dario0603/Unipi-Frequency-generator/PSD_project/img/BCD_to_C2_converter_BCD_C2_conv_inst.jpg

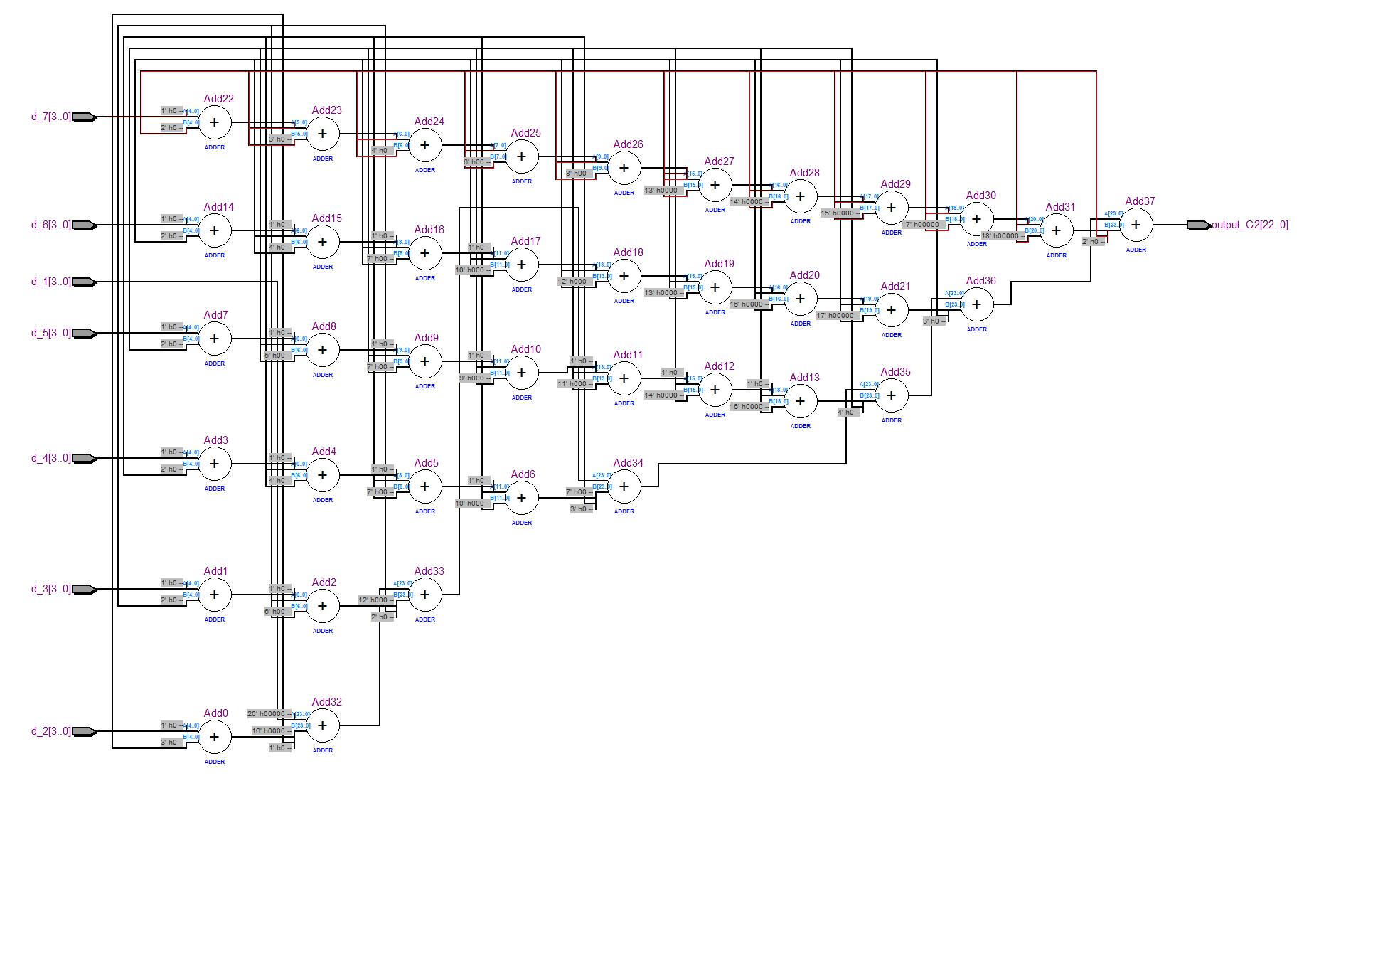
PSD_project/img/BCD_to_C2_converter_BCD_C2_conv_inst.jpg
