dario0603/Unipi-Frequency-generator/PSD_project/img/DDFS_frequency_converter_DDFS_freq_conv_inst.jpg

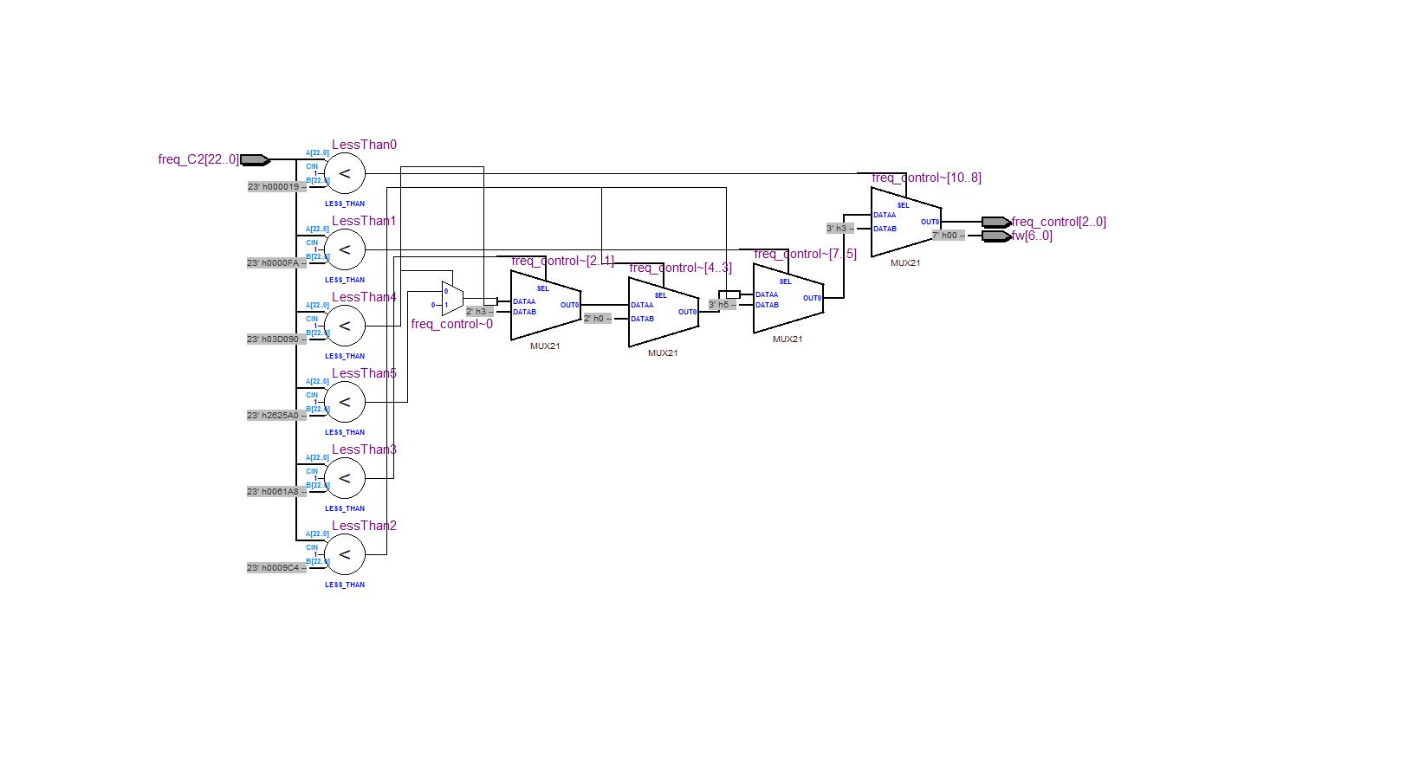
PSD_project/img/DDFS_frequency_converter_DDFS_freq_conv_inst.jpg
