dario0603/Unipi-Frequency-generator/PSD_project/img/ddfs_inst2.jpg

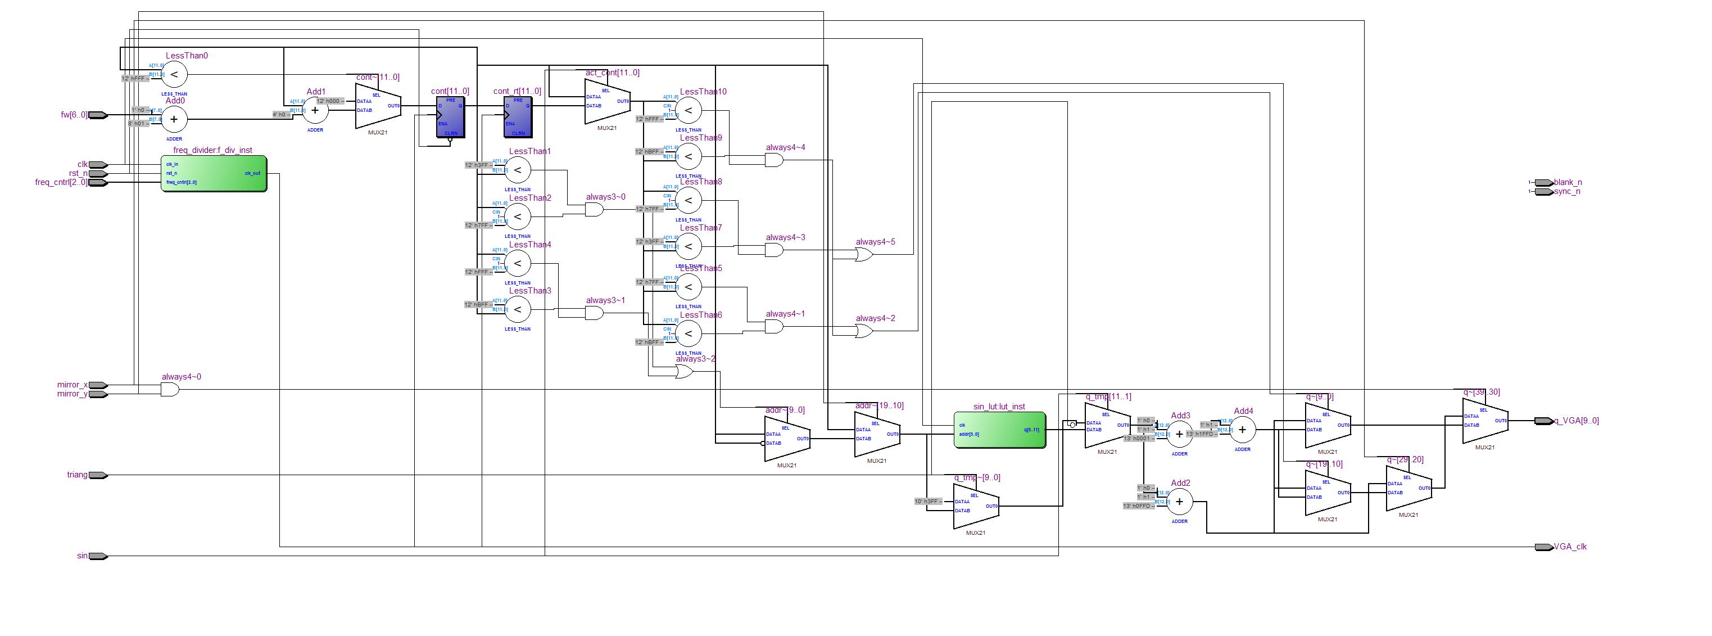
PSD_project/img/ddfs_inst2.jpg
