dario0603/Unipi-Frequency-generator/PSD_project/img/freq_divider_f_div_inst.jpg

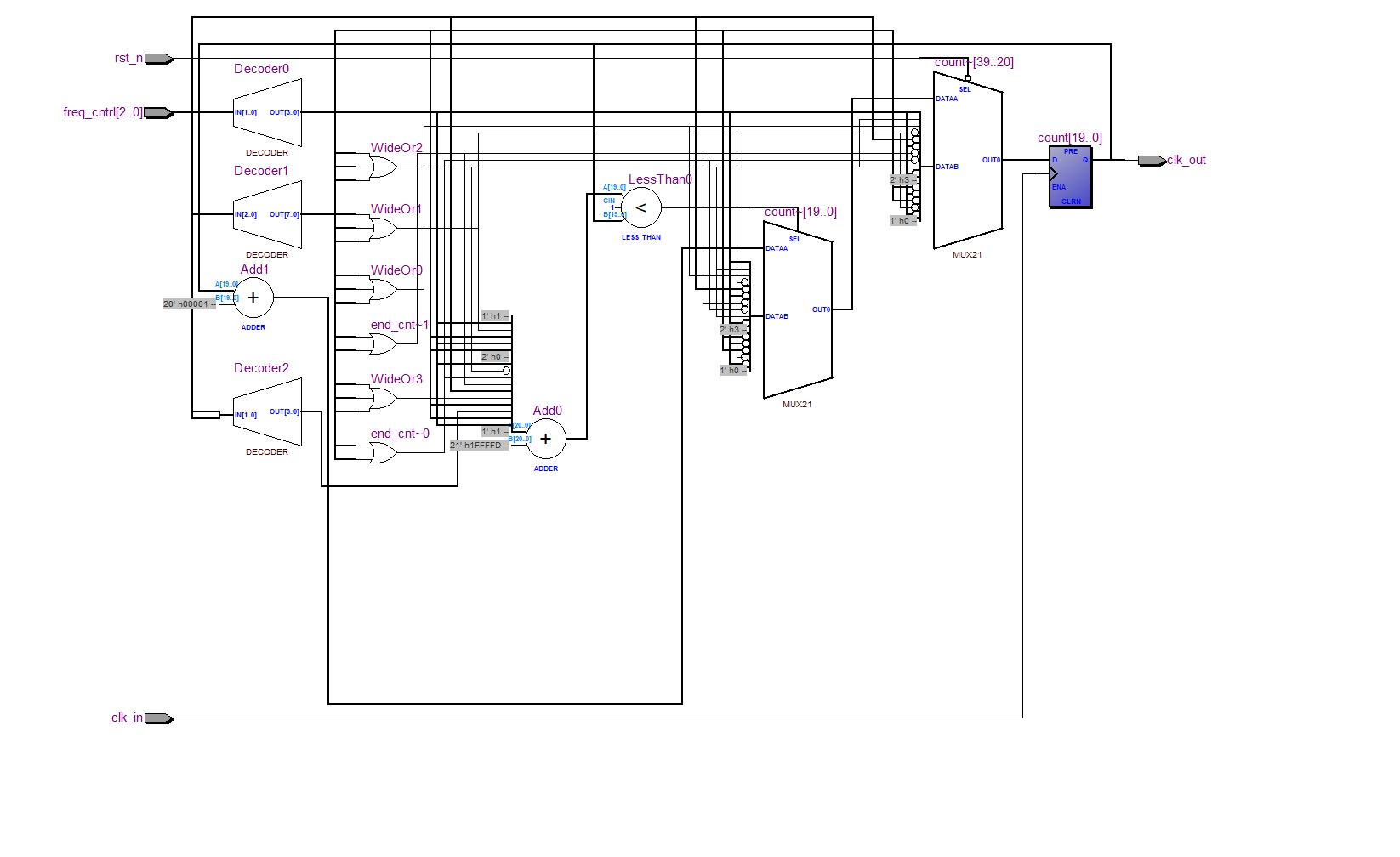
PSD_project/img/freq_divider_f_div_inst.jpg
