dario0603/Unipi-Frequency-generator/PSD_project/img/keypad_freq_sel_module_inst3.jpg

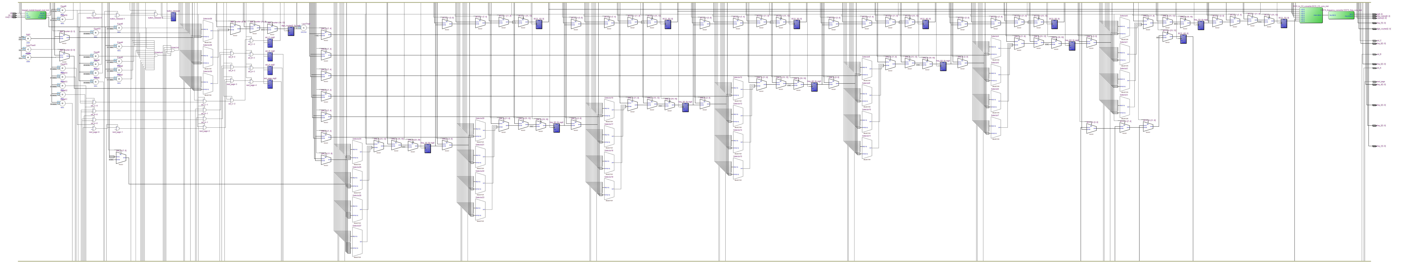
PSD_project/img/keypad_freq_sel_module_inst3.jpg
