dario0603/Unipi-Frequency-generator/PSD_project/img/keypad_module_keypad_mod_inst.jpg

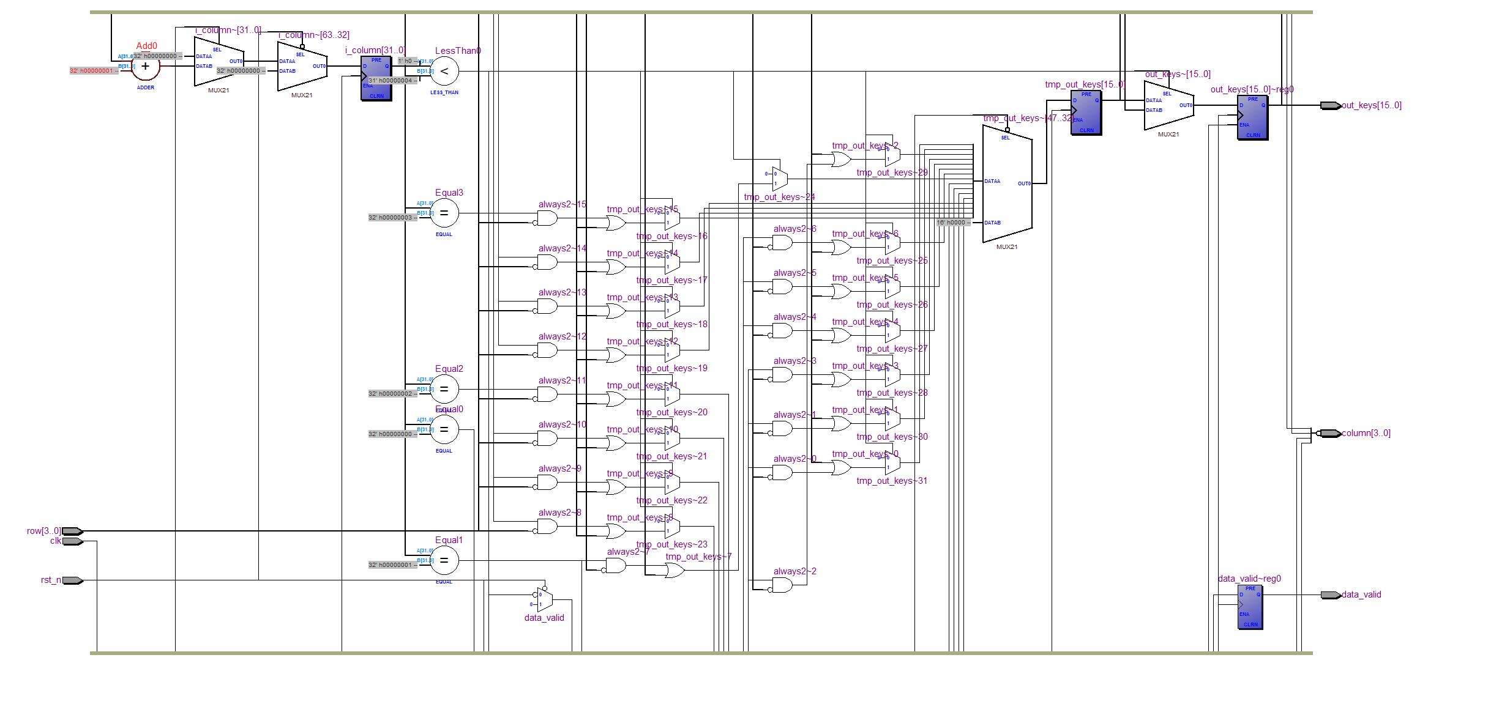
PSD_project/img/keypad_module_keypad_mod_inst.jpg
