dario0603/Unipi-Frequency-generator/PSD_project/img/main_function_generator_RTL.jpg

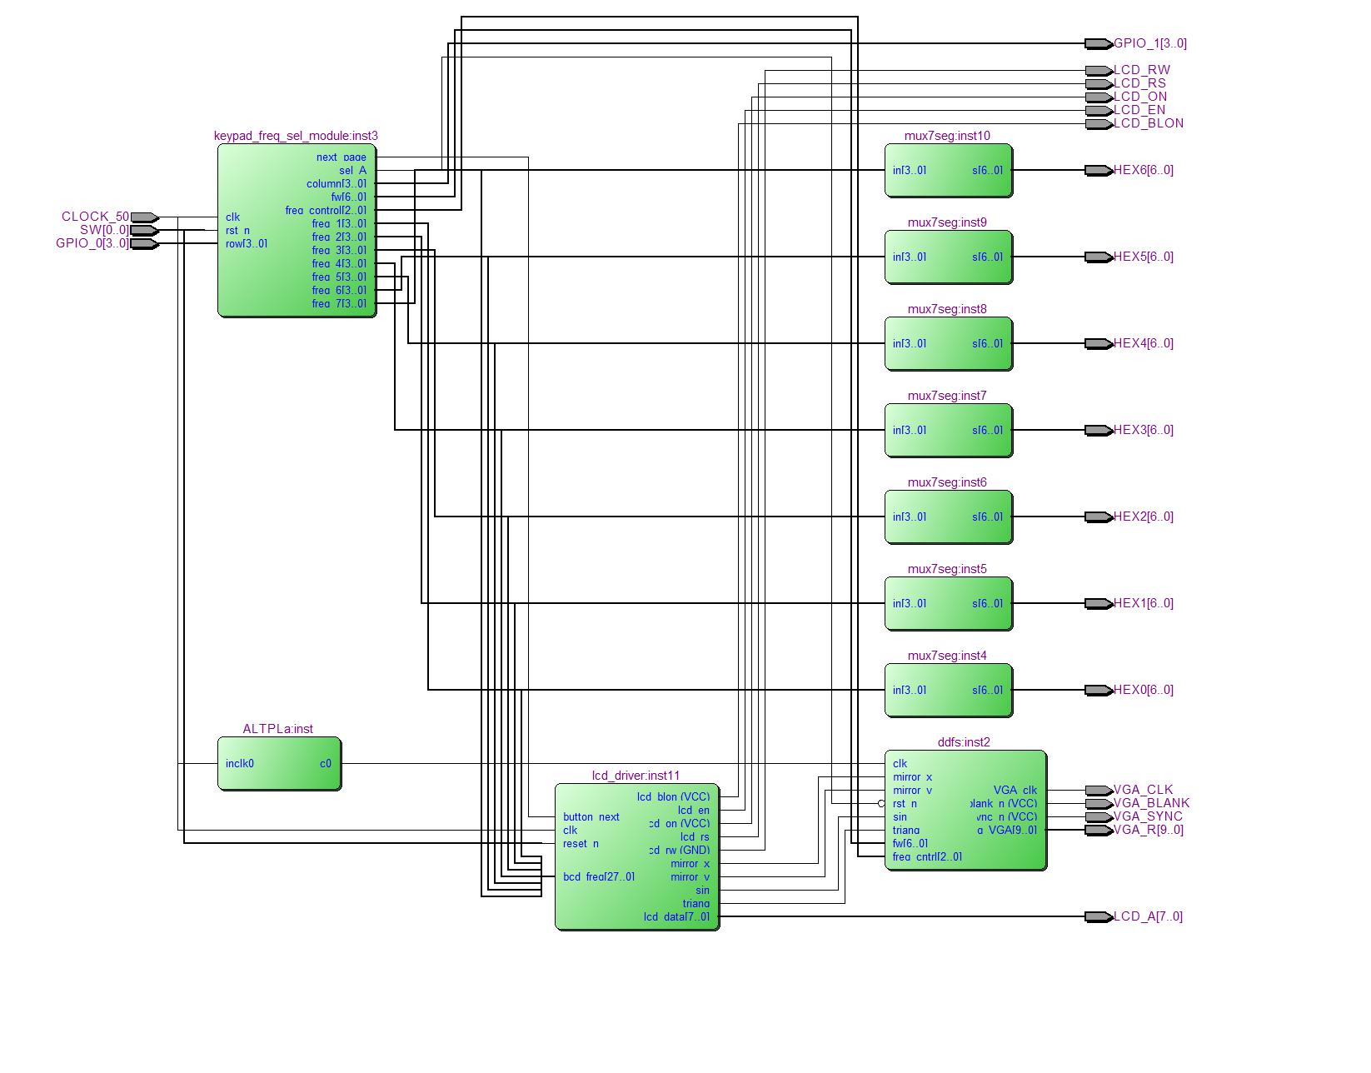
PSD_project/img/main_function_generator_RTL.jpg
