dario0603/Unipi-Frequency-generator/(list of files, cad)

Other CAD files:
main_function_generator - with dividers/modules/DDFS module/VGA DAC/simulation/modelsim/rtl_work/ddfs/verilog.psm
main_function_generator - with dividers/modules/DDFS module/VGA DAC/simulation/modelsim/rtl_work/tb_ddfs/verilog.psm
main_function_generator - with dividers/modules/Keypad_frequency_select_module/simulation/modelsim/rtl_work/@d@d@f@s_frequency_converter/verilog.psm
main_function_generator - with dividers/modules/Keypad_frequency_select_module/simulation/modelsim/rtl_work/keypad_freq_sel_module/verilog.psm
main_function_generator - with dividers/modules/Keypad_frequency_select_module/simulation/modelsim/rtl_work/keypad_module/verilog.psm
main_function_generator - with dividers/modules/Keypad_module/simulation/modelsim/rtl_work/keypad_module/verilog.psm
main_function_generator/modules/DDFS module/VGA DAC/simulation/modelsim/rtl_work/ddfs/verilog.psm
main_function_generator/modules/DDFS module/VGA DAC/simulation/modelsim/rtl_work/tb_ddfs/verilog.psm
main_function_generator/modules/Keypad_frequency_select_module/simulation/modelsim/rtl_work/@b@c@d_to_@c1_converter/verilog.psm
main_function_generator/modules/Keypad_frequency_select_module/simulation/modelsim/rtl_work/@d@d@f@s_frequency_converter/verilog.psm
main_function_generator/modules/Keypad_frequency_select_module/simulation/modelsim/rtl_work/keypad_freq_sel_module/verilog.psm
main_function_generator/modules/Keypad_frequency_select_module/simulation/modelsim/rtl_work/keypad_module/verilog.psm
main_function_generator/simulation/modelsim/rtl_work/@a@l@t@p@l@la/verilog.psm
main_function_generator/simulation/modelsim/rtl_work/@b@c@d_to_@c1_converter/verilog.psm
main_function_generator/simulation/modelsim/rtl_work/@d@d@f@s_frequency_converter/verilog.psm
main_function_generator/simulation/modelsim/rtl_work/ddfs/verilog.psm
main_function_generator/simulation/modelsim/rtl_work/freq_divider_@d@d@f@s/verilog.psm
main_function_generator/simulation/modelsim/rtl_work/keypad_4x4/verilog.psm
main_function_generator/simulation/modelsim/rtl_work/keypad_freq_sel_module/verilog.psm
main_function_generator/simulation/modelsim/rtl_work/keypad_module/verilog.psm
main_function_generator/simulation/modelsim/rtl_work/lcd_driver/verilog.psm
main_function_generator/simulation/modelsim/rtl_work/mux7seg/verilog.psm
main_function_generator/simulation/modelsim/rtl_work/sin_lut/verilog.psm
main_function_generator/simulation/modelsim/rtl_work/tb_keypad_module/verilog.psm
main_function_generator/simulation/modelsim/rtl_work/text_lut/verilog.psm
modules/DDFS module/12 bit DAC/simulation/modelsim/rtl_work/altpla/syn.psm
modules/DDFS module/12 bit DAC/simulation/modelsim/rtl_work/ddfs/verilog.psm
modules/DDFS module/12 bit DAC/simulation/modelsim/rtl_work/freq_divider/verilog.psm
modules/DDFS module/12 bit DAC/simulation/modelsim/rtl_work/freq_divider_@d@d@f@s/verilog.psm
modules/DDFS module/12 bit DAC/simulation/modelsim/rtl_work/sin_lut/verilog.psm
modules/DDFS module/12 bit DAC/simulation/modelsim/rtl_work/tb_ddfs/verilog.psm
modules/DDFS module/VGA DAC/simulation/modelsim/rtl_work/altpla/syn.psm
modules/DDFS module/VGA DAC/simulation/modelsim/rtl_work/ddfs/verilog.psm
modules/DDFS module/VGA DAC/simulation/modelsim/rtl_work/freq_divider_@d@d@f@s/verilog.psm
modules/DDFS module/VGA DAC/simulation/modelsim/rtl_work/sin_lut/verilog.psm
modules/DDFS module/VGA DAC/simulation/modelsim/rtl_work/tb_ddfs/verilog.psm
modules/DDFS_frequency_converter/simulation/modelsim/rtl_work/@d@d@f@s_frequency_converter/verilog.psm
modules/DDFS_frequency_converter/simulation/modelsim/rtl_work/tb_@d@d@f@s_frequency_converter/verilog.psm
modules/Keypad_frequency_select_module/simulation/modelsim/rtl_work/@b@c@d_to_@c1_converter/verilog.psm
modules/Keypad_frequency_select_module/simulation/modelsim/rtl_work/@b@c@d_to_@c2_converter/verilog.psm
modules/Keypad_frequency_select_module/simulation/modelsim/rtl_work/@d@d@f@s_frequency_converter/verilog.psm
modules/Keypad_frequency_select_module/simulation/modelsim/rtl_work/freq_divider_keypad_module/verilog.psm
modules/Keypad_frequency_select_module/simulation/modelsim/rtl_work/keypad_4x4/verilog.psm
modules/Keypad_frequency_select_module/simulation/modelsim/rtl_work/keypad_freq_sel_module/verilog.psm
modules/Keypad_frequency_select_module/simulation/modelsim/rtl_work/keypad_module/verilog.psm
modules/Keypad_frequency_select_module/simulation/modelsim/rtl_work/mux7seg/verilog.psm
modules/Keypad_frequency_select_module/simulation/modelsim/rtl_work/tb_keypad_module/verilog.psm
modules/Keypad_module/simulation/modelsim/rtl_work/freq_divider/verilog.psm
modules/Keypad_module/simulation/modelsim/rtl_work/keypad_4x4/verilog.psm
modules/Keypad_module/simulation/modelsim/rtl_work/keypad_module/verilog.psm
modules/Keypad_module/simulation/modelsim/rtl_work/tb_keypad_module/verilog.psm
