dario0603/Unipi-Frequency-generator/main_function_generator/simulation/modelsim/rtl_work/@d@d@f@s_frequency_converter/_primary.vhd

library verilog;
use verilog.vl_types.all;
entity DDFS_frequency_converter is
    generic(
        CLK_FREQ        : vl_logic_vector(63 downto 0) := (Hi0, Hi0, Hi0, Hi0, Hi0, Hi0, Hi0, Hi0, Hi0, Hi0, Hi0, Hi0, Hi0, Hi0, Hi0, Hi0, Hi0, Hi0, Hi0, Hi0, Hi0, Hi0, Hi0, Hi0, Hi0, Hi0, Hi0, Hi0, Hi0, Hi0, Hi0, Hi0, Hi0, Hi0, Hi0, Hi0, Hi1, Hi0, Hi1, Hi1, Hi1, Hi1, Hi1, Hi0, Hi1, Hi0, Hi1, Hi1, Hi1, Hi1, Hi0, Hi0, Hi0, Hi0, Hi1, Hi0, Hi0, Hi0, Hi0, Hi0, Hi0, Hi0, Hi0, Hi0)
    );
    port(
        clk             : in     vl_logic;
        rst_n           : in     vl_logic;
        freq            : in     vl_logic_vector(22 downto 0);
        mirror_x        : in     vl_logic;
        mirror_y        : in     vl_logic;
        fw              : out    vl_logic_vector(6 downto 0);
        freq_control    : out    vl_logic_vector(2 downto 0)
    );
    attribute mti_svvh_generic_type : integer;
    attribute mti_svvh_generic_type of CLK_FREQ : constant is 2;
end DDFS_frequency_converter;
