dario0603/Unipi-Frequency-generator/main_function_generator/simulation/modelsim/rtl_work/mux7seg/_primary.vhd

library verilog;
use verilog.vl_types.all;
entity mux7seg is
    port(
        \in\            : in     vl_logic_vector(3 downto 0);
        s               : out    vl_logic_vector(6 downto 0)
    );
end mux7seg;
