dario0603/Unipi-Frequency-generator/main_function_generator/simulation/modelsim/rtl_work/ddfs/_primary.vhd

library verilog;
use verilog.vl_types.all;
entity ddfs is
    port(
        sin             : in     vl_logic;
        triang          : in     vl_logic;
        mirror_x        : in     vl_logic;
        mirror_y        : in     vl_logic;
        fw              : in     vl_logic_vector(6 downto 0);
        clk             : in     vl_logic;
        rst_n           : in     vl_logic;
        freq_cntrl      : in     vl_logic_vector(2 downto 0);
        q_VGA           : out    vl_logic_vector(9 downto 0);
        VGA_clk         : out    vl_logic;
        blank_n         : out    vl_logic;
        sync_n          : out    vl_logic
    );
end ddfs;
