dario0603/Unipi-Frequency-generator/modules/DDFS module/12 bit DAC/simulation/modelsim/rtl_work/tb_ddfs/_primary.vhd

library verilog;
use verilog.vl_types.all;
entity tb_ddfs is
    generic(
        CLOCK_PERIOD    : integer := 10
    );
    attribute mti_svvh_generic_type : integer;
    attribute mti_svvh_generic_type of CLOCK_PERIOD : constant is 1;
end tb_ddfs;
