dario0603/Unipi-Frequency-generator/(commit log)

2025-12-02 added first modules
    [verilog.psm]
2025-12-02 fixed retiming register problem
    [ddfs.v]
2025-12-02 keypad module reader added
    [verilog.psm]
2025-12-05 final module created, BUT NOT TESTED
    [LCD_module.smp_dump.txt, function_generator.smp_dump.txt, verilog.psm]
2025-12-06 DDFS paramater -> localparam and main module builded NOT TESTED
    [verilog.psm]
2025-12-13 final version rev0 tested with LCD bugs
    [Keypad_module.smp_dump.txt, LCD_module.smp_dump.txt, function_generator.smp_dump.txt, main_function_generator.smp_dump.txt, verilog.psm]
2025-12-14 DDFS testbench fixed and sin_lut clock bug fixed
    [verilog.psm]
2025-12-14 fixed DDFS frequency divider testbench
    [tb_freq_divider.v]
2025-12-14 fixed DDFS VGA testbench
    [syn.psm, verilog.psm]
2025-12-14 fixed the keypad testbench
    [verilog.psm]
2025-12-14 fixed testbench for DDFS freq conv module
    [DDFS_frequency_converter.v, tb_DDFS_frequency_converter.v]
2025-12-14 added report file
    [verilog.psm]
2025-12-15 fixed LCD module
    [main_function_generator.smp_dump.txt, verilog.psm]
2025-12-15 fixed DDFS waveform oscillation
    [syn.psm, verilog.psm]
2025-12-17 final version tested rev1
    [verilog.psm]
2025-12-18 fixed DDFS bug
    [Keypad_module.smp_dump.txt, LCD_module.smp_dump.txt, main_function_generator.smp_dump.txt, syn.psm, verilog.psm]
2025-12-18 fixed DDFS bug again
    [verilog.psm]
2025-12-18 updated report
    [verilog.psm]
2025-12-23 metastable latch protection added and timing analysis done, not tested
    [Keypad_module.smp_dump.txt, LCD_module.smp_dump.txt, main_function_generator.smp_dump.txt, syn.psm, verilog.psm]
2025-12-24 final version rev1 not tested
    [Keypad_module.smp_dump.txt, LCD_module.smp_dump.txt, main_function_generator.smp_dump.txt, syn.psm, verilog.psm]
2025-12-26 fixed timing analysis not tested
    [syn.psm, verilog.psm]
2025-12-27 rev2 not tested and report updated
    [Keypad_module.smp_dump.txt, LCD_module.smp_dump.txt, syn.psm, verilog.psm]
